Maaz-qureshi98/Swarm-Autobots/media/cad_side.png

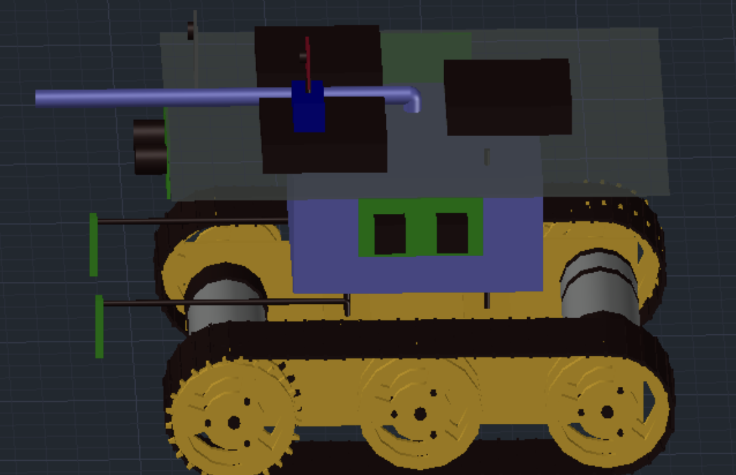
media/cad_side.png
