Maaz-qureshi98/Swarm-Autobots/media/cad_top.png

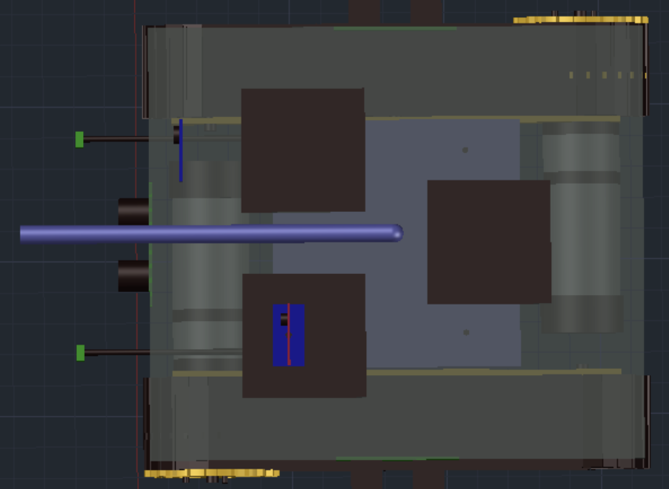
media/cad_top.png
