Maaz-qureshi98/Swarm-Autobots/media/teaser.png

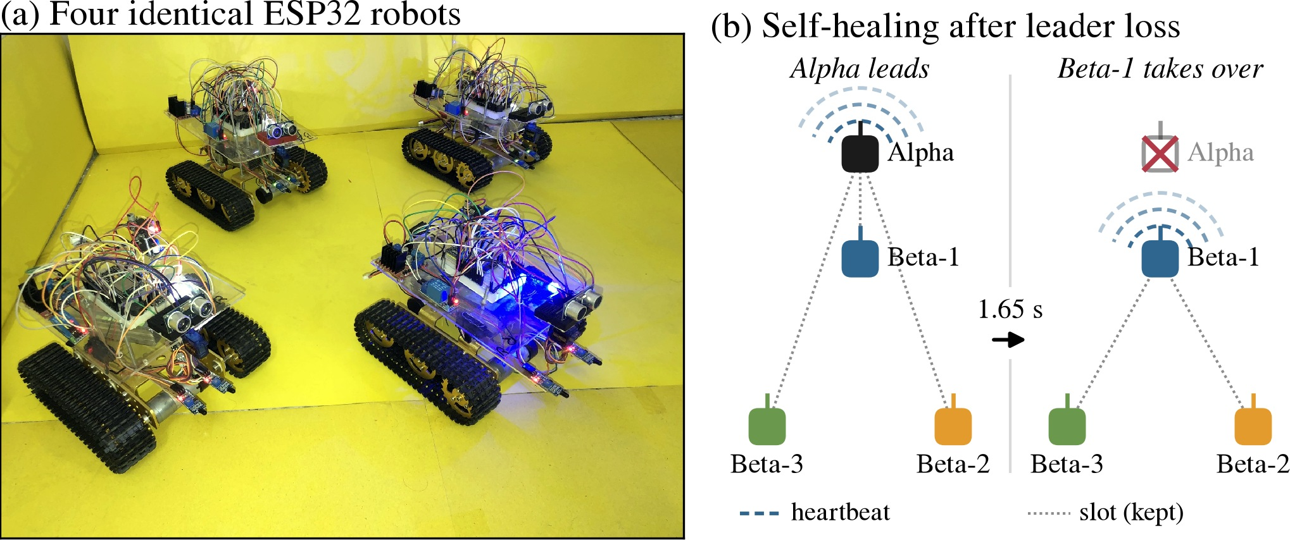
media/teaser.png
