Maaz-qureshi98/Swarm-Autobots/sim/figs_hw/hero.jpg

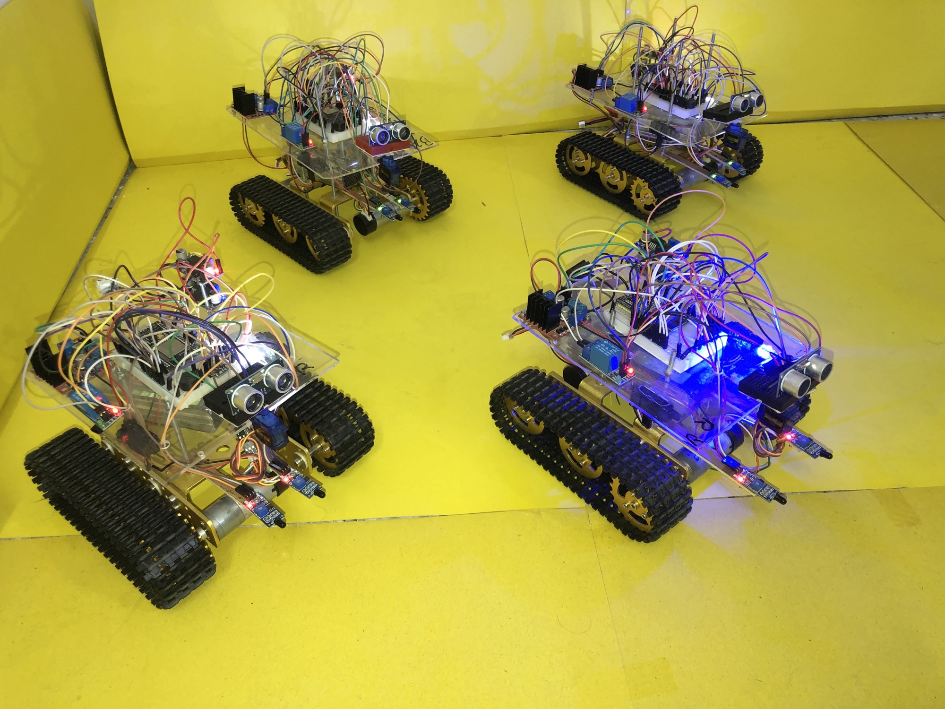
sim/figs_hw/hero.jpg
