Maaz-qureshi98/Swarm-Autobots/sim/figs_hw/hw_case3_v2.jpg

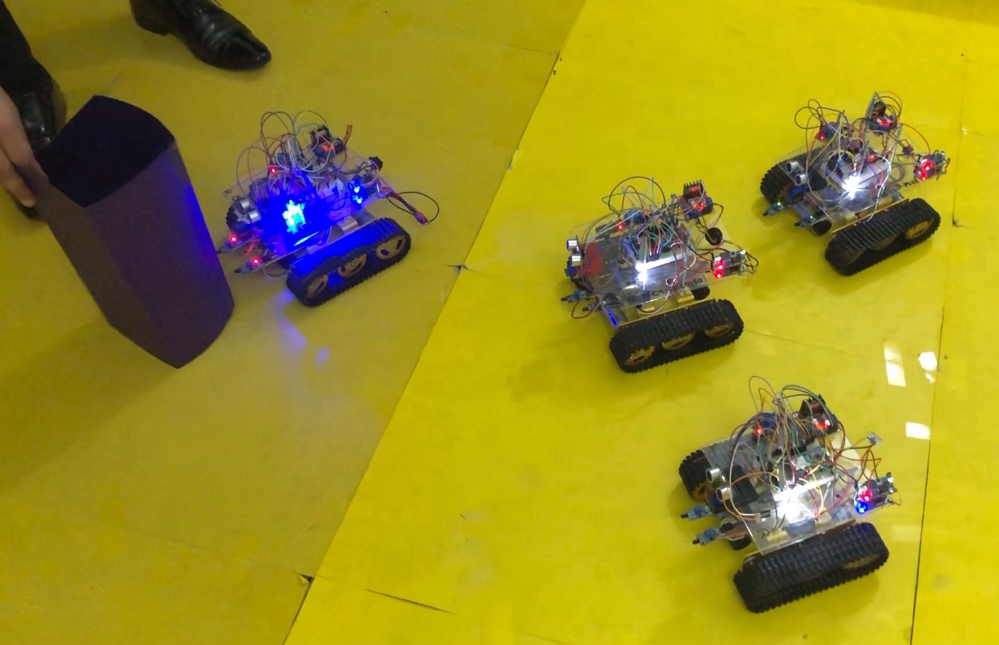
sim/figs_hw/hw_case3_v2.jpg
