Maaz-qureshi98/Swarm-Autobots/sim/figs_hw/hw_case4_v2.jpg

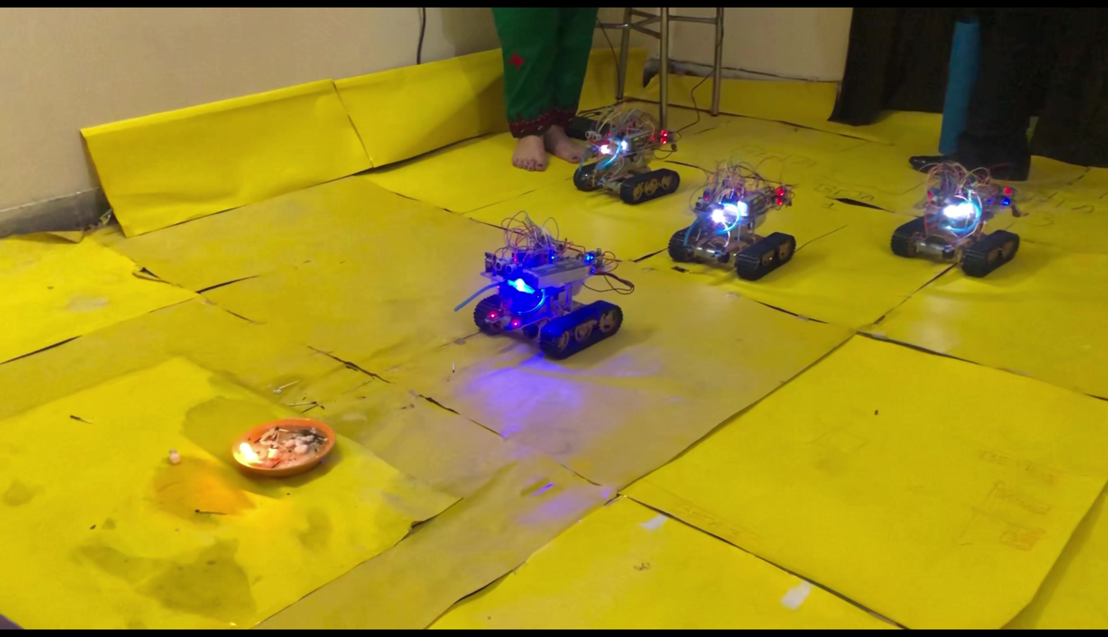
sim/figs_hw/hw_case4_v2.jpg
