Maaz-qureshi98/Swarm-Autobots/(commit log)

2026-10-05 Contact studies with the 0.142 m circumscribed footprint; larger figure text
    - e13_footprint.py: rerun safety, ablation, lambda sweep, and Table I conditions with R = 0.142 m
    - make_figs.py: Fig. 5 shows missions with contact; larger fonts in Figs. 4 and 5; Point + ZOH label
    - make_cases_fig.py, make_robot_fig.py: larger labels, 0.142 m disc
    - README, docs/reproduce.md: updated safety results and consensus numbers
2026-10-05 Larger annotation and legend text in the four-case and packet-loss figures
2026-10-05 Four-case figure: plain black labels without white outlines, labels moved off arrows
2026-10-05 Four-case figure: white-filled label markers as in Fig. 2, thinner leader lines
2026-10-05 Revision studies: predictor and safety baselines, localization sweep, effect sizes
    - core: constant-velocity and constant-acceleration predictors, range-based
    potential field, contact time and coexisting-leader metrics
    - e14_revision.py: hardware-consistent and ideal localization models, safety
    baselines, election coexistence, Table I at 0.142 m
    - e15_revision2.py: hardware-consistent loss sweep, burst lengths, localization
    sweep (compass bias 0-4 deg)
    - effects.py: paired bootstrap CIs for the prediction gain
    - make_figs.py: Fig. 4 with localization panels; scalability as fig_scale
2026-10-05 Firmware: ZOH mode, loss injection, cycle timing, compass test
    - SwarmAgent.h / agent.py: predict switch (ZOH mode), packet age accessor
    - equivalence test covers ZOH mode (5 scenarios, 15716 steps, 0 mismatches)
    - HwExperiment.h: Gilbert-Elliott drop injection, micros() cycle stats, CSV log
    - compass_cal.ino and analysis scripts; hardware trial protocol
2026-10-06 CI: wait for ROS 2 discovery before checking swarm topics, always print the launch log
2026-10-17 Correct range-filter claims and add conservative planar weighting
    The range filter is a sampled-data speed restriction, not a control
    barrier function. Its guarantee holds for a stationary compact reflector
    that remains the detected return through the step; for an extended plane
    normal to travel the admissible speed carries cos(beta) rather than its
    reciprocal, so the shipped form is permissive there.
    Add Cfg.cbf_plane to select the conservative weighting. Default False
    reproduces the shipped rule bit for bit, including its association order,
    so every archived result is unchanged.
    Also honour a shared_recovery method flag in control_step, so a
    potential-field configuration can use the same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
2026-10-19 Restyle Fig. 2 to match the architecture flowchart
    Use the flowchart's gray box fill, dark outline, and bold box titles in the
    power and signal wiring panel, mute the signal and sensor colours, and widen
    the sensor-layout axes so the footprint label is no longer clipped.
2026-10-19 Route Fig. 2 wiring connectors orthogonally
    Replace the slanted power arrows with right-angle connectors, label the 12 V and 5 V rails, and draw every connector with the same solid arrowhead so dashed signal lines keep crisp heads.
