Maaz-qureshi98/Swarm-Autobots/(notices)

Notices in the files:
README.md:
License: MIT
